jhoud/e511b01a0/test/doc/WPL1321HMI-V1.0-BOM.xlsx

Sheet: WPL1321HMI-V1.0-BOM
返回主页 | 轿内显示板V1.0（BOM清单） |  |  |  |  |  |  |  |  | 板子名称：WPL1321HMI(轿内显示板V1.0)
查找代号 | 器件名称 | 焊接代号 | WPL封装别名 | 封装 | 参数 | 描述 | 工作温度 | 品牌 | 单套数量 | 备注
WPL1321A
001 | LED | D1, D2, D3, D4, D5, D6, D7, D8, D9, D10, D11, D12, D13, D14, D15, D16, D17, D18, D19, D20, D21, D22, D23, D24, D25, D26, D27, D28, D29, D30, D31, D32, D33, D34, D35, D36, D37, D38, D39, D40, D41, D42, D43, D44, D45, D46, D47, D48, D49, D50, D51, D52, D53…… | RESC1608FL | 0603 | RED | Typical RED, GREEN, YELLOW, AMBER GaAs LED | -40～+85℃ | Everlight（台湾亿光） | 284
WPL1321B
001 | 瓷片电容 | C1, C4, C6, C7, C8, C9, C10, C18, C20 | CAPC1005L | 0402 | 100nF | 104 X7R, Ceramic Capacitor | -55～+125℃ | YAGEO / SAMSUNG / TDK | 9
002 | 瓷片电容 | C2, C3 | CAPC1005L | 0402 | 20pF | 104 X7R | -55～+125℃ | YAGEO / SAMSUNG / TDK | 2
003 | 瓷片电容 | C5 | CAPC1005L | 0402 | 1uF | 104 X7R | -55～+125℃ | YAGEO / SAMSUNG / TDK | 1
004 | 瓷片电容 | C11 | CAPC1608L | 0603 | 10uF/25V | Ceramic Capacitor | -55～+125℃ | YAGEO / SAMSUNG / TDK | 1
005 | 瓷片电容 | C12 | CAPC1005L | 0402 | 220pF | Ceramic Capacitor | -55～+125℃ | YAGEO / SAMSUNG / TDK | 1
006 | 瓷片电容 | C15 | 1210 | 1210 | 10uF/50V | Ceramic Capacitor,C3225X5R1H106 | -55～+125℃ | YAGEO / SAMSUNG / TDK | 1
007 | 瓷片电容 | C16, C19 | CAPC1005L | 0402 | 100pF | 104 X7R | -55～+125℃ | YAGEO / SAMSUNG / TDK | 2
008 | 瓷片电容 | C17 | CAPC1005L | 0402 | 2.2nF | 104 X7R | -55～+125℃ | YAGEO / SAMSUNG / TDK | 1
009 | 二极管 | D143 | SMB-1 | SMB | 1N4007 | Default Diode | -65～+175℃ | Kexin | 1
010 | 二极管 | D160 | DSO-C2/X2.3 | SMB | SS26 | Schottky Diode | -65～+150℃ | General Semiconductor | 1
011 | TVS | D287 | SOT-23 PSM712 | SOT-23 | PSM712 | TVS | -50～+150℃ | Protekdevices | 1
012 | 自恢复保险丝 | F1 | 1210 | 1210 | SMD1210P020TF | Resettable Fuse | -40～+85℃ | Polytronics | 1
013 | 电感 | L2 | L10uH | SMD6*6 | SLF6025T-330M1R59-PF | Inductor(33uH) | -40～+105℃ | TDK | 1
014 | 三极管 | Q1, Q2, Q3, Q4, Q5, Q6, Q7, Q8, Q9 | 318-08FL | SOT-23 | DTB113ZK G11 | Digital Transistor PNP Silicon | -50～+150℃ | Rohm | 9
015 | 贴片电阻 | R1, R9 | RESC1005L | 0402 | 510 | Resistor,1% | -55～+155℃ | YAGEO | 2
016 | 贴片电阻 | R2 | RESC1005L | 0402 | 100k | Resistor, 1% | -55～+155℃ | YAGEO | 1
017 | 贴片电阻 | R3 | RESC1005L | 0402 | 220k | Resistor, 1% | -55～+155℃ | YAGEO | 1
018 | 贴片电阻 | R4 | RESC1005L | 0402 | 120k | Resistor, 1% | -55～+155℃ | YAGEO | 1
019 | 贴片电阻 | R5 | RESC1005L | 0402 | 200k | Resistor, 1% | -55～+155℃ | YAGEO | 1
020 | 贴片电阻 | R6 | RESC1005L | 0402 | 41.2k | Resistor, 1% | -55～+155℃ | YAGEO | 1
021 | 贴片电阻 | R7, R8, R10, R11, R12, R13, R14, R15 | RESC1005L | 0402 | 2k7 | Resistor,1% | -55～+155℃ | YAGEO | 8
022 | TVS | TVS1 | SMB-1 | SMB | SMBJ26A | TVS | -55～+150℃ | Panjit/Fairchild | 1
023 | IC | U1, U4 | SOP24-MBI5026GP | SOP-24 | MBI5024GP | 16-Channel Constant Current LED Sink Driver | -40～+85℃ | Macroblock | 2
024 | MCU | U2 | LQFP48_L | LQFP48_L | STM8S208 | ST 8bit MCU | -40～+85℃ | ST | 1
025 | IC | U3 | 751-02_N | SOIC8 | MP2562 | DC-DC 1A 50V | -40～+85℃ | MPS | 1
026 | IC | U5 | D008_L | SOT96-1 | TJA1050 | CANbus tranceiver | -40～+150℃ | NXP | 1
027 | 光学传感器 | U6, U7, U8 | L24 | 3.2*2.7*1.5 | L24 | Optical Sensors | —— | Everlight（台湾亿光） | 3
028 | 贴片压敏电阻 | VR1 | 1206 | 1206 | FPV321611E240PKT | Varistor (Voltage-Sensitive Resistor) | -55～+125℃ | 风华高科 | 1
029 | 无源晶振 | Y1 | XTAL5032 | 5032 | 16M | Crystal Oscillator | -40～+85℃ | X.D.L.（鑫达利电子） | 1
标记 | 解释 | 说明 |  |  |  |  |  |  | 硬件设计：咸春峰、张效奎 2014-01-13
 | 部分缺料 | 仅样品配置了的材料。
 | 缺料 | 缺料或为采购到；PCB空位（未焊接）。
 | 临时不处置 | 没有配置材料或没有焊接，参数需要按现场计算。
 | 已配齐的器件 | 已焊接或配备了的元件。 |  |  |  |  |  |  | 版本号：V1.0
提供2套半成品硬件，（样品为手工焊接）其余的配齐元件，共计5套。 |  |  |  |  |  |  |  |  | PCB型号：——

Sheet: 附图
图4 总体效果图
