jhoud/e511b01a0/(list of files, cad)

Other CAD files:
source/indisp.stp
