jhoud/e511b01a0/test/test/超薄板测试can协议.docx

外呼板测试程序之通讯协议

- 通讯方式: CAN,通讯速率: 50Kbps 帧格式:标准帧 帧类型:数据帧
- CAN ID定义
  - 主（PC）：ID不限
  - 从（外呼板）ID: 0x00
- 主设备传从设备（外呼）内容

ID | IDE | RTR | DLC | DATA
不限 | 标准帧 | 数据帧 | 最少两个 | 0xff 0xff -- -- -- -- -- --

-- ：代表可有可无

数据格式：为8位16进制数据

- 从设备（外呼）->主设备通讯内容

ID | IDE | RTR | DLC | DATA
0x00 | 标准帧 | 数据帧 | 7 | A B 0x00 0x00 0x00 0x00 0x00

A、B: 代表当前显示的楼层数 A代表十位数 B代表个位数

当数字为“B”“--”“P”的时候代表的数字分别是：0x0a、0x0b、0x0c；

数据格式：为8位16进制数据
