jhoud/e511b01a0/test/sch-pcb-pdf/WPL1321AHMI(V1.0).pdf

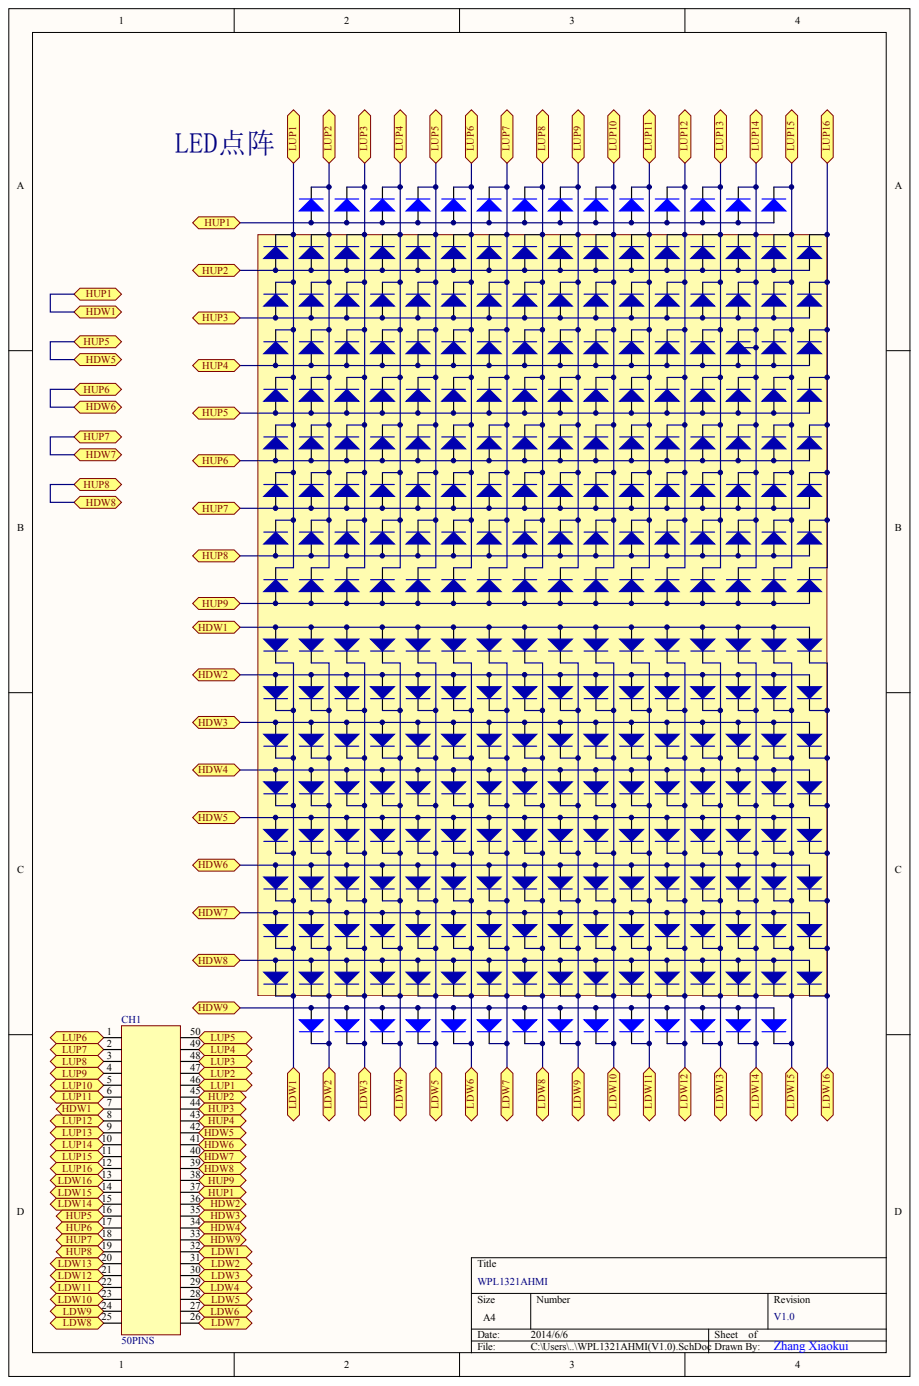
[picture p2: page 1]
