jhoud/e511b01a0/test/sch-pcb-pdf/WPL1321AHMI(V1.0)pcb.pdf

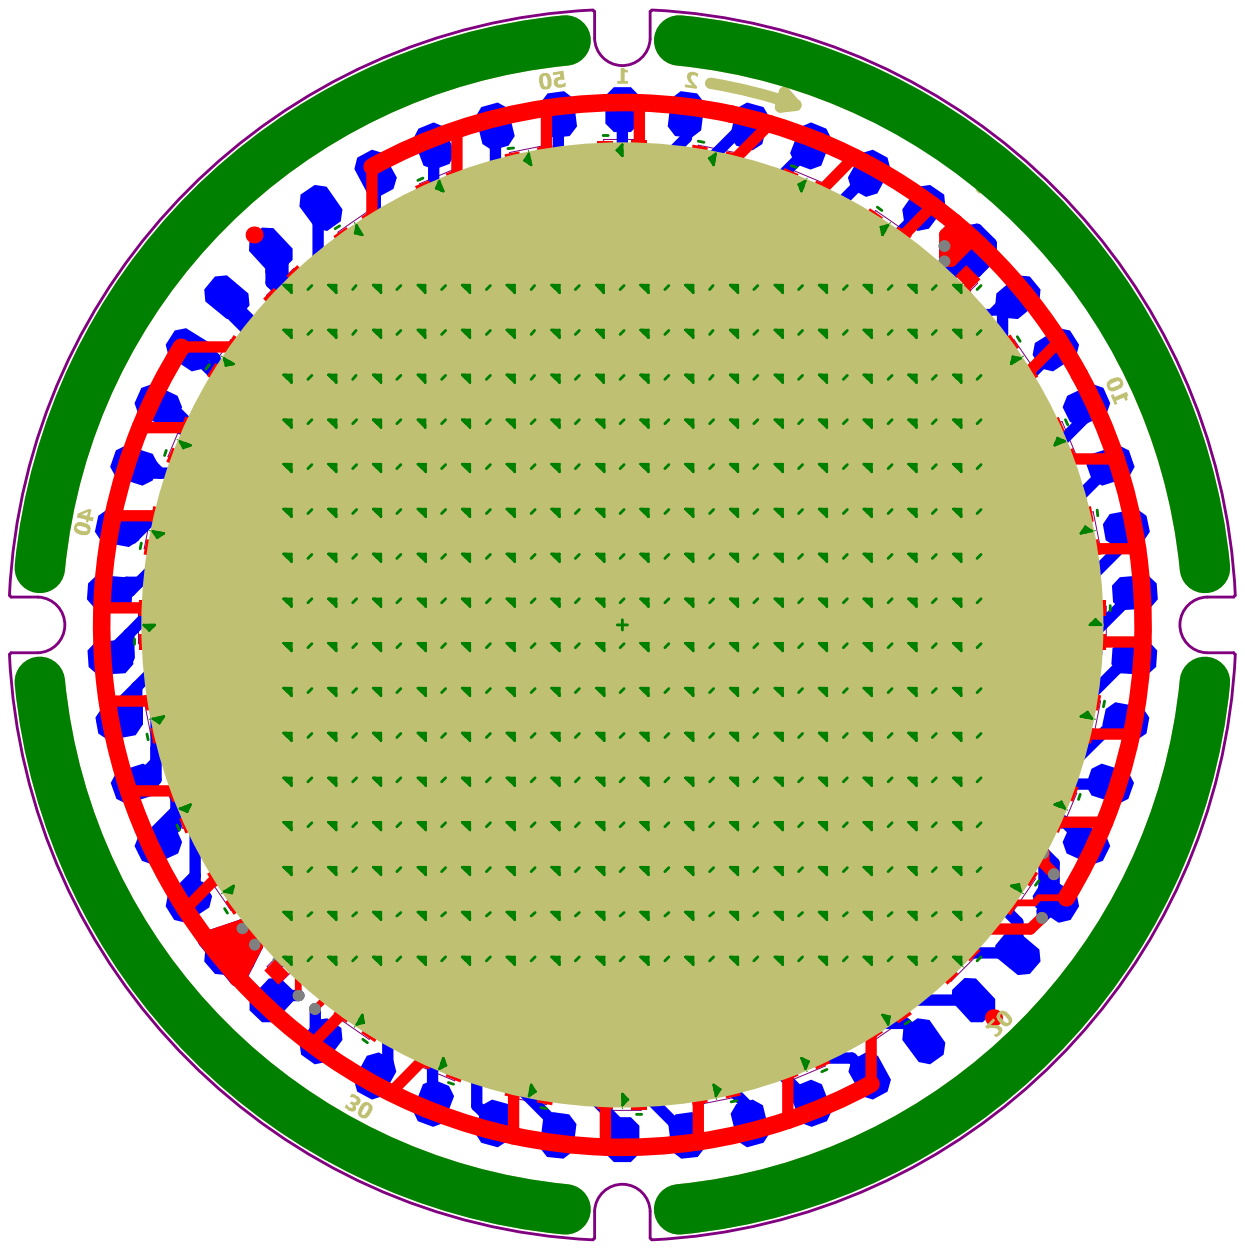
[picture p3: page 1]
