jhoud/e511b01a0/test/sch-pcb-pdf/WPL1321BHMI(V1.0).pdf

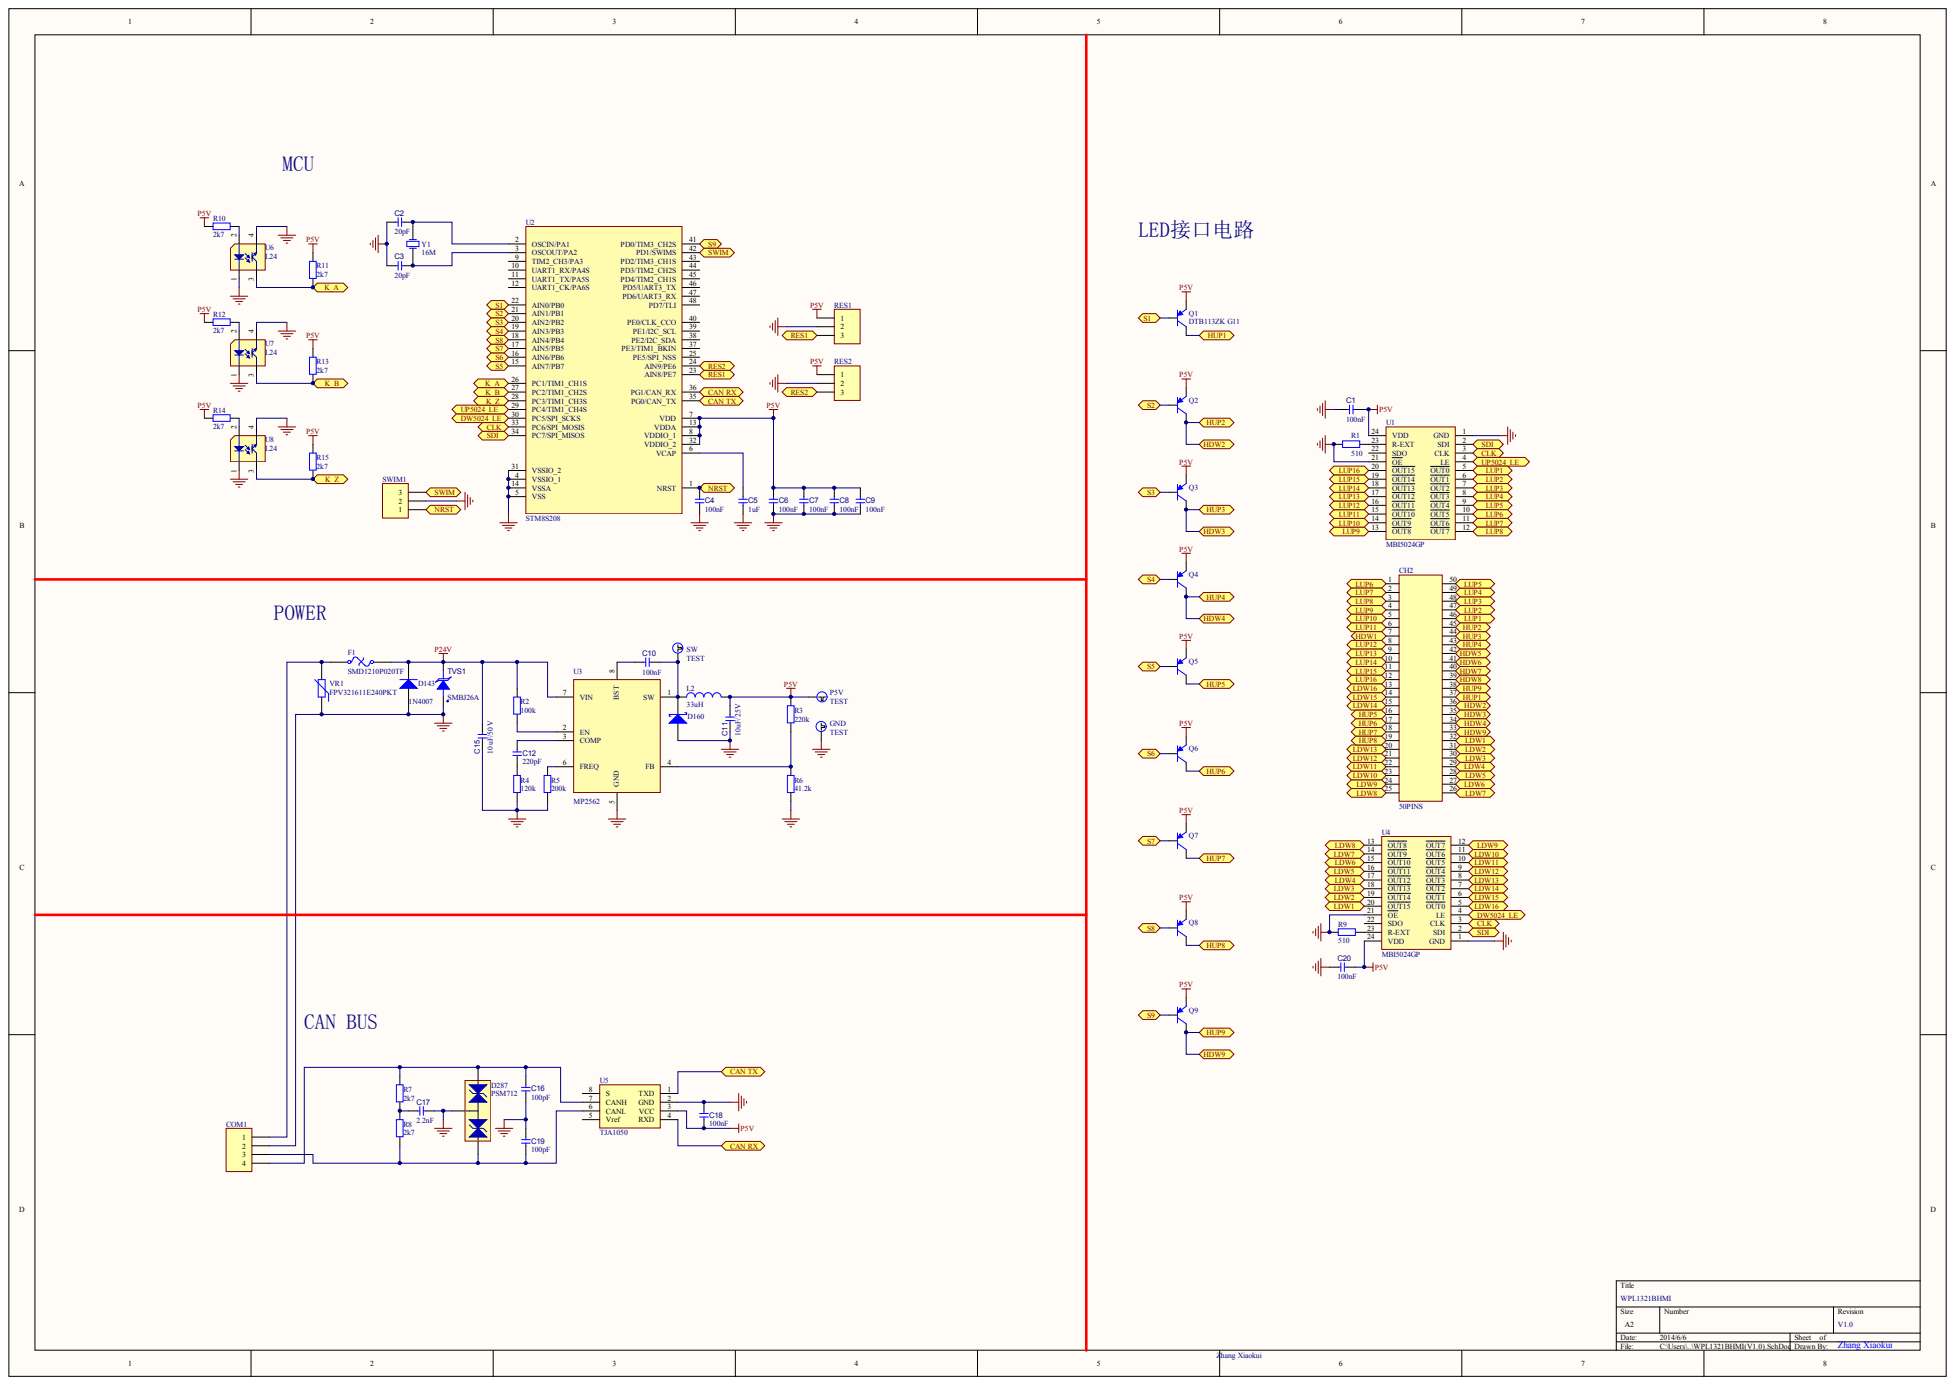
[picture p4: page 1]

C18
100nF
