jhoud/e511b01a0/test/sch-pcb-pdf/WPL1321BHMI(V1.0)pcb.pdf

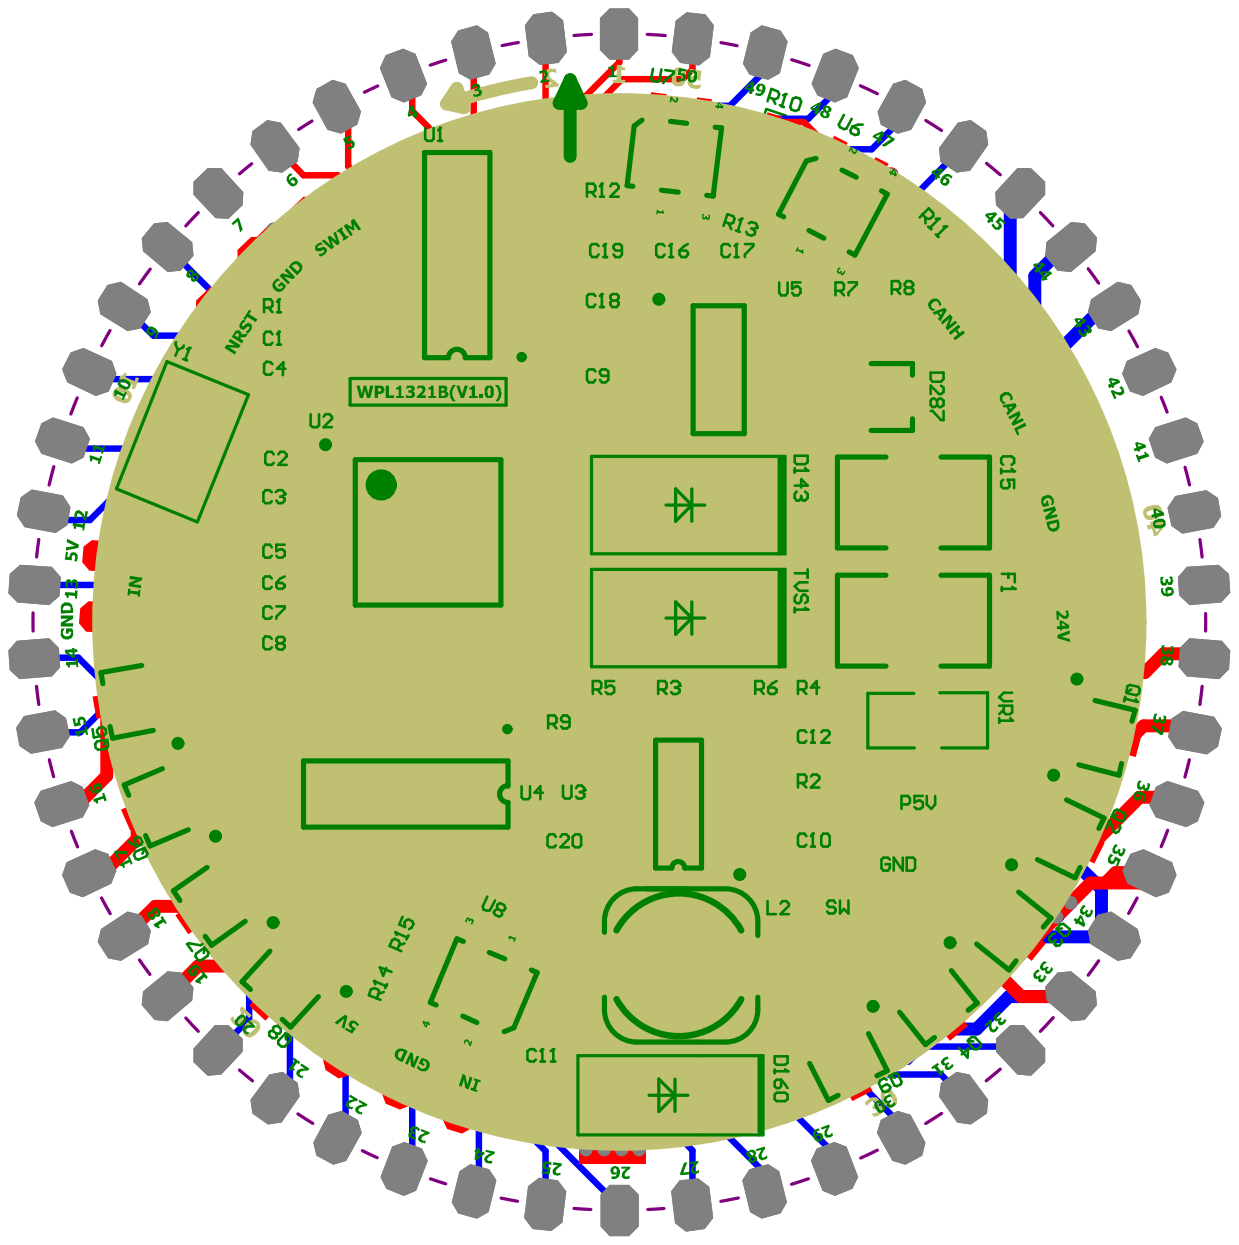
[picture p5: page 1]
