jhoud/e511b01a0/test/sch-pcb-pdf/轿内显示板钢网文件.pdf

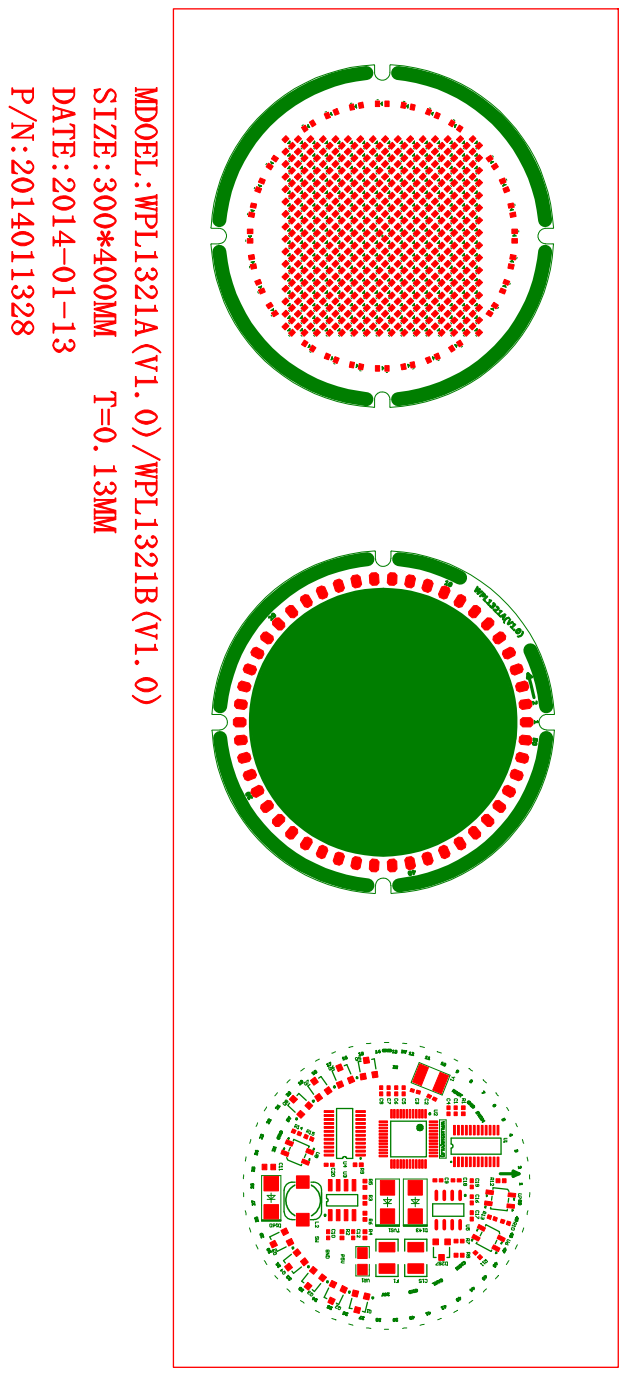
[picture p6: page 1]
