jhoud/e511b01a0/(list of files, drawings)

Other design files:
test/sch pcb/WPL1321A(V1.0).SchDoc
test/sch pcb/WPL1321B(V1.0).SchDoc
